minhz99/project_3/documentation/Tu_viet_tat.tex

% !TeX root = ../main.tex

%\makeglossaries
\makenoidxglossaries

% Tạo glossary mới cho ký hiệu
\newglossary[symg]{symbols}{syi}{syo}{DANH SÁCH KÝ HIỆU}

% Danh mục thuật ngữ và từ viết tắt
\newglossaryentry{TGN}{
    type=\acronymtype,
    name={TGN},
    description={Tháp giải nhiệt},
    first={Tháp giải nhiệt (TGN)},
}
\newglossaryentry{TĐN}{
    type=\acronymtype,
    name={TĐN},
    description={Trao đổi nhiệt},
    first={Trao đổi nhiệt (TĐN)},
}

\newglossaryentry{import}{
    type=\acronymtype,
    name={i},
    description={Dòng lưu chất đi vào thiết bị},
    sort={1}
}

\newglossaryentry{export}{
    type=\acronymtype,
    name={e},
    description={Dòng lưu chất ra khỏi thiết bị},
    sort={2}
}

\newglossaryentry{delta}{
    type=symbols,
    name={$\Delta$},
    description={Độ chênh lệch}
}

\newglossaryentry{t}{
    type=symbols,
    name={$t$},
    description={Nhiệt độ}
}

\newglossaryentry{eta}{
    type=symbols,
    name={$\eta$},
    description={Hiệu suất}
}
