minhz99/project_3/documentation/Chuong/0_0_Loi_cam_doan.tex

% !TeX root = ../main.tex

\documentclass[../main.tex]{subfiles}
\begin{document}

\begin{center}
    \Large{\textbf{LỜI CAM ĐOAN}}\\
\end{center}
\vspace{1cm}

Tôi xin cam đoan rằng: Đồ án tốt nghiệp với đề tài “Thiết kế hệ thống IoT giám sát và tính toán thông số tháp giải nhiệt” là kết quả nghiên cứu và thiết kế do chính tôi thực hiện, dưới sự hướng dẫn khoa học của thầy Đỗ Mạnh Hùng.

Các số liệu, kết quả tính toán, bản vẽ thiết kế và phân tích kỹ thuật trong đồ án được trình bày trung thực, phản ánh đúng quá trình thực hiện. Những nội dung không do tôi trực tiếp tạo ra đều đã được trích dẫn và ghi rõ nguồn theo đúng quy định.

Tôi hoàn toàn chịu trách nhiệm về tính chính xác, trung thực và khách quan của toàn bộ nội dung trong đồ án này.

\begin{flushright}
Sinh viên thực hiện\\
\begin{tabular}{@{}c@{}}
\textit{(Ký và ghi rõ họ tên)}
\end{tabular}
\end{flushright}
\end{document}
