minhz99/project_3/documentation/Chuong/0_1_Loi_cam_on.tex

% !TeX root = ../main.tex

\documentclass[../main.tex]{subfiles}
\pagenumbering{roman}
\begin{document}
\begin{center}
    \Large{\textbf{LỜI CẢM ƠN}}\\
\end{center}
\vspace{1cm}
Em xin gửi lời cảm ơn chân thành và kính trọng tới thầy Đỗ Mạnh Hùng — người đã đồng hành, định hướng và động viên em trong suốt quá trình thực hiện đồ án tốt nghiệp cũng như những bước đầu làm quen với nghiên cứu. Nhờ sự hướng dẫn sát sao của thầy, em không chỉ vượt qua các vướng mắc kỹ thuật mà còn mở rộng tư duy, tiếp cận có hệ thống các vấn đề về IoT và ứng dụng trong các hệ thống năng lượng công nghiệp.

Những góp ý thẳng thắn, tỉ mỉ và tinh thần làm việc nghiêm túc của thầy giúp em rèn luyện phương pháp nghiên cứu, nâng cao năng lực tự học và giữ vững nhiệt huyết theo đuổi đề tài. Em đặc biệt trân trọng sự tận tâm của thầy khi luôn sẵn sàng lắng nghe, giải đáp và chia sẻ kinh nghiệm quý báu, qua đó định hình rõ ràng mục tiêu, phạm vi và cách tiếp cận của đồ án.

Em cũng xin chân thành cảm ơn Phòng thí nghiệm Nghiên cứu Nhiên liệu và Năng lượng sạch (FCE Lab) – Trường Cơ khí, Trường Đại học Bách khoa Hà Nội – đã hỗ trợ cơ sở vật chất và môi trường làm việc thuận lợi để em triển khai thí nghiệm và thu thập dữ liệu cho đề tài. Sự hỗ trợ kịp thời và điều kiện nghiên cứu do phòng thí nghiệm tạo ra là tiền đề quan trọng giúp em hoàn thành đồ án này.
\end{document}
