minhz99/project_3/documentation/Hinhve/cau_tao.jpg

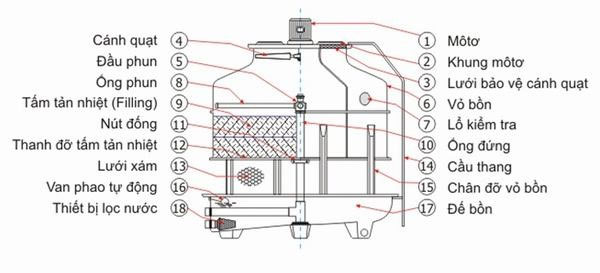
documentation/Hinhve/cau_tao.jpg
