minhz99/project_3/documentation/Hinhve/Cooling-Tower-Efficiency.jpg

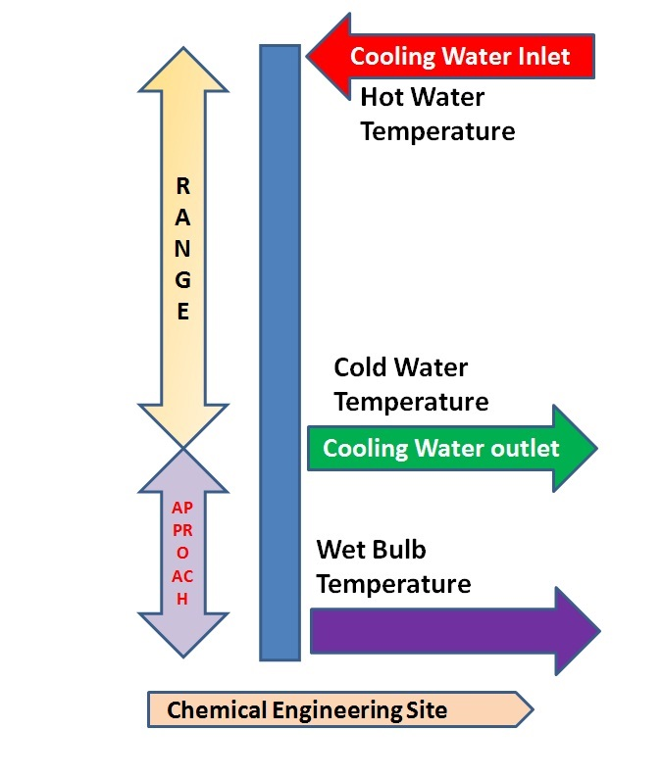
documentation/Hinhve/Cooling-Tower-Efficiency.jpg
