minhz99/project_3/documentation/Hinhve/cooling_tower1.jpg

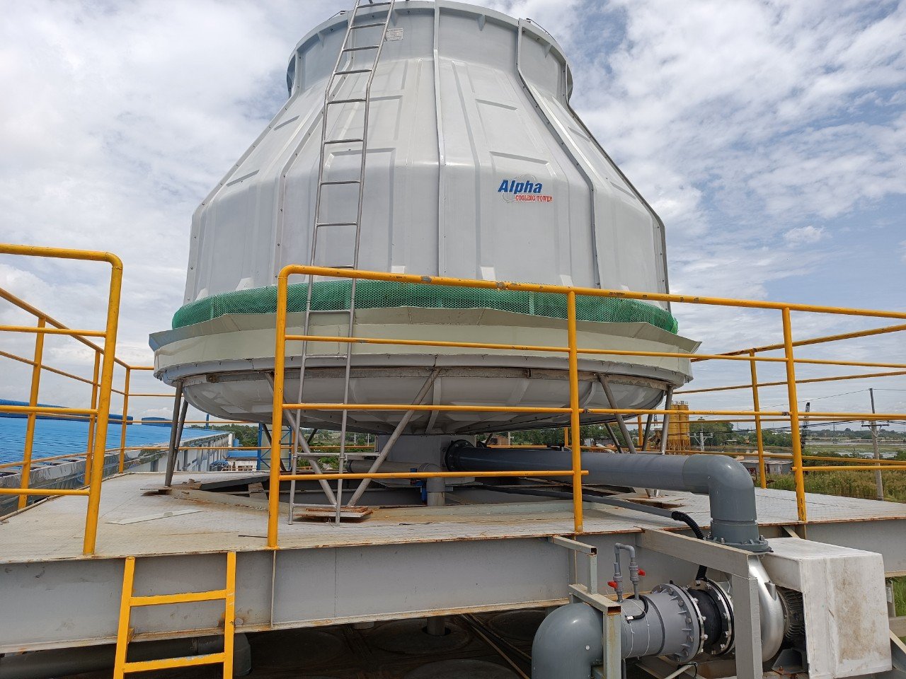
documentation/Hinhve/cooling_tower1.jpg
