minhz99/project_3/documentation/Hinhve/cooling_tower.jpg

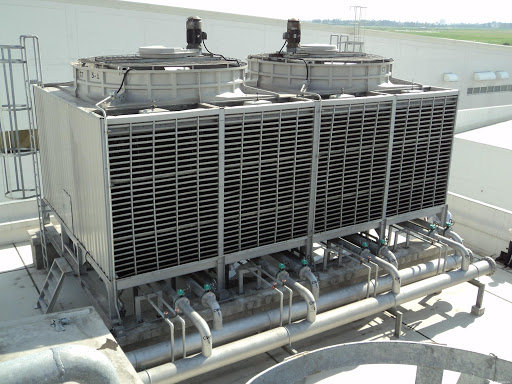
documentation/Hinhve/cooling_tower.jpg
