minhz99/project_3/documentation/Hinhve/esp32_devkit.png

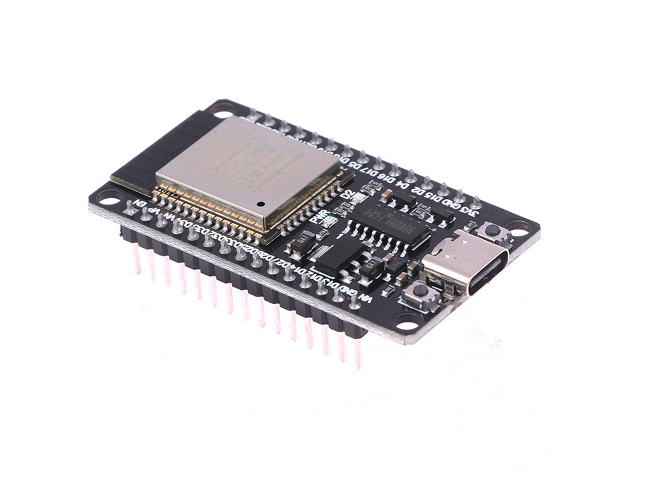
documentation/Hinhve/esp32_devkit.png
