minhz99/project_3/documentation/Hinhve/grafana.jpg

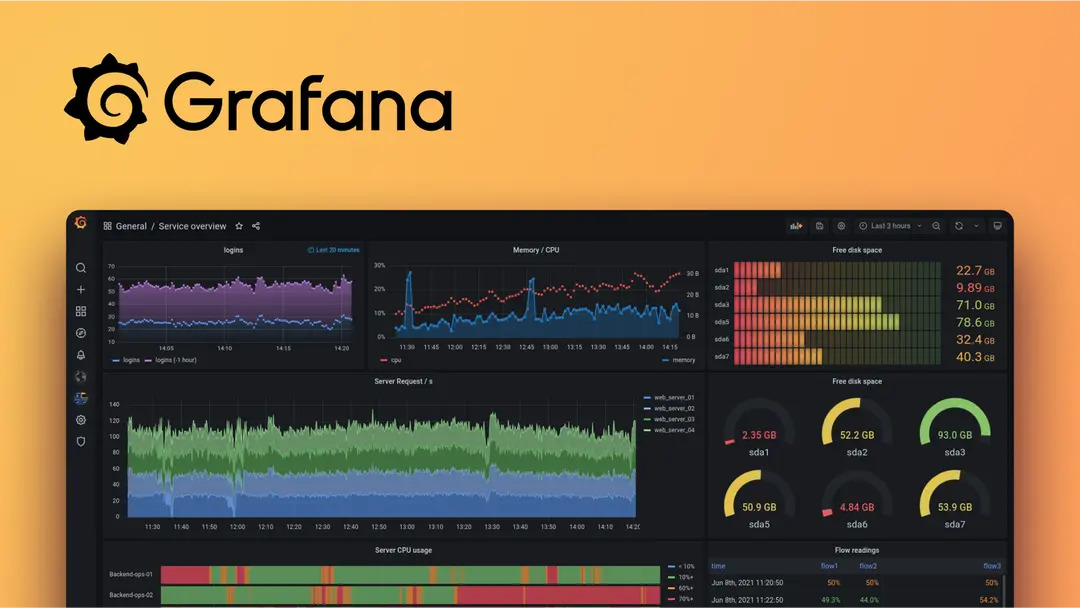
documentation/Hinhve/grafana.jpg
