minhz99/project_3/documentation/Hinhve/mo_hinh_thap.jpg

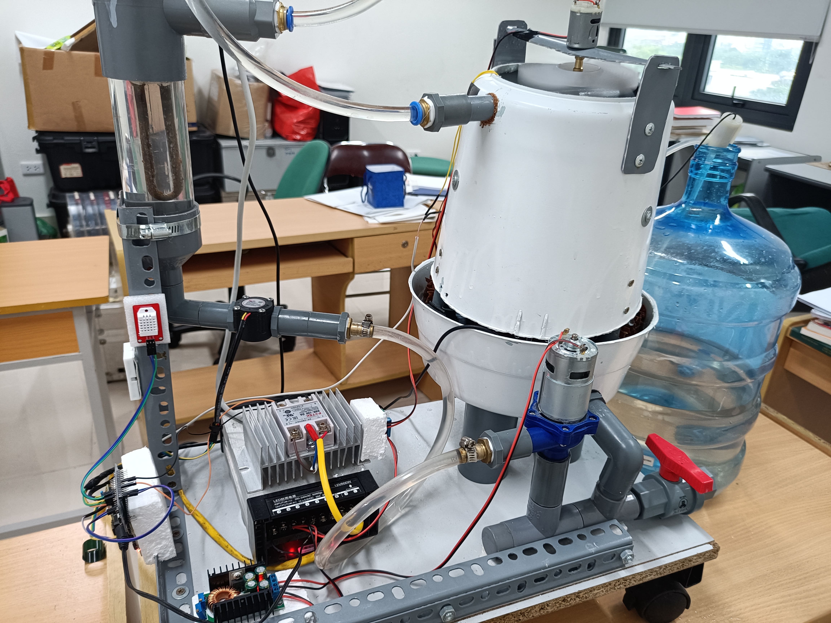
documentation/Hinhve/mo_hinh_thap.jpg
